svenssonjoel/AnimatronicsController/Hardware/v1/v1.kicad_pcb

## KiCad design Hardware/v1/v1.kicad_pcb (2020-01-16)

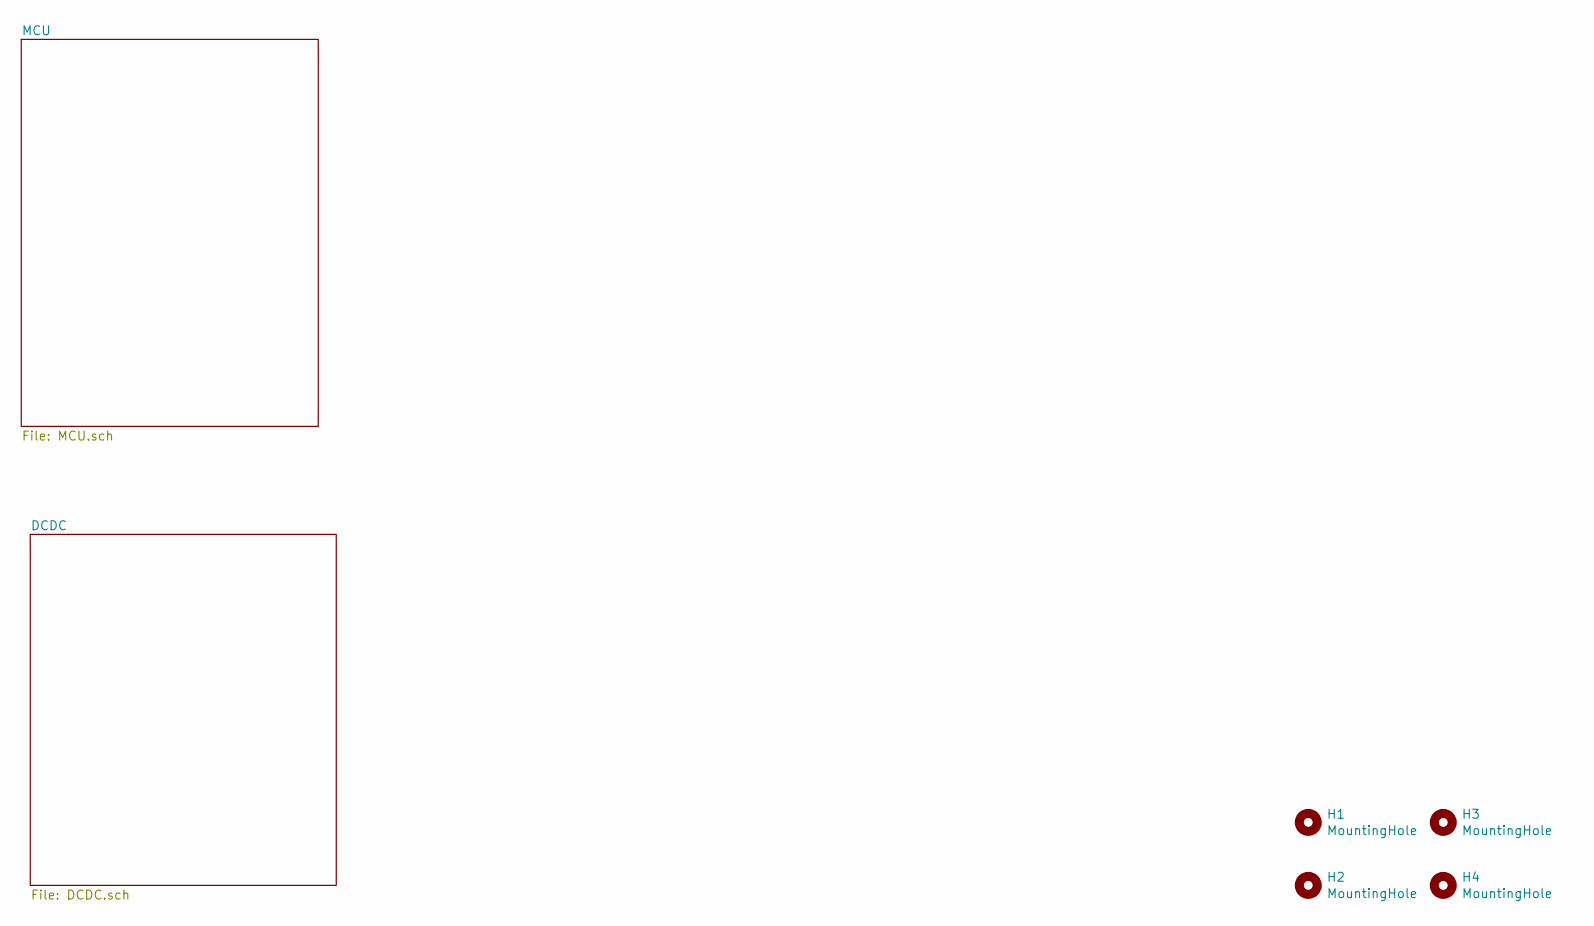
[picture p4: schematic v1.sch]

Parts:
H1, H2, H3, H4: MountingHole; MountingHole_3.2mm_M3

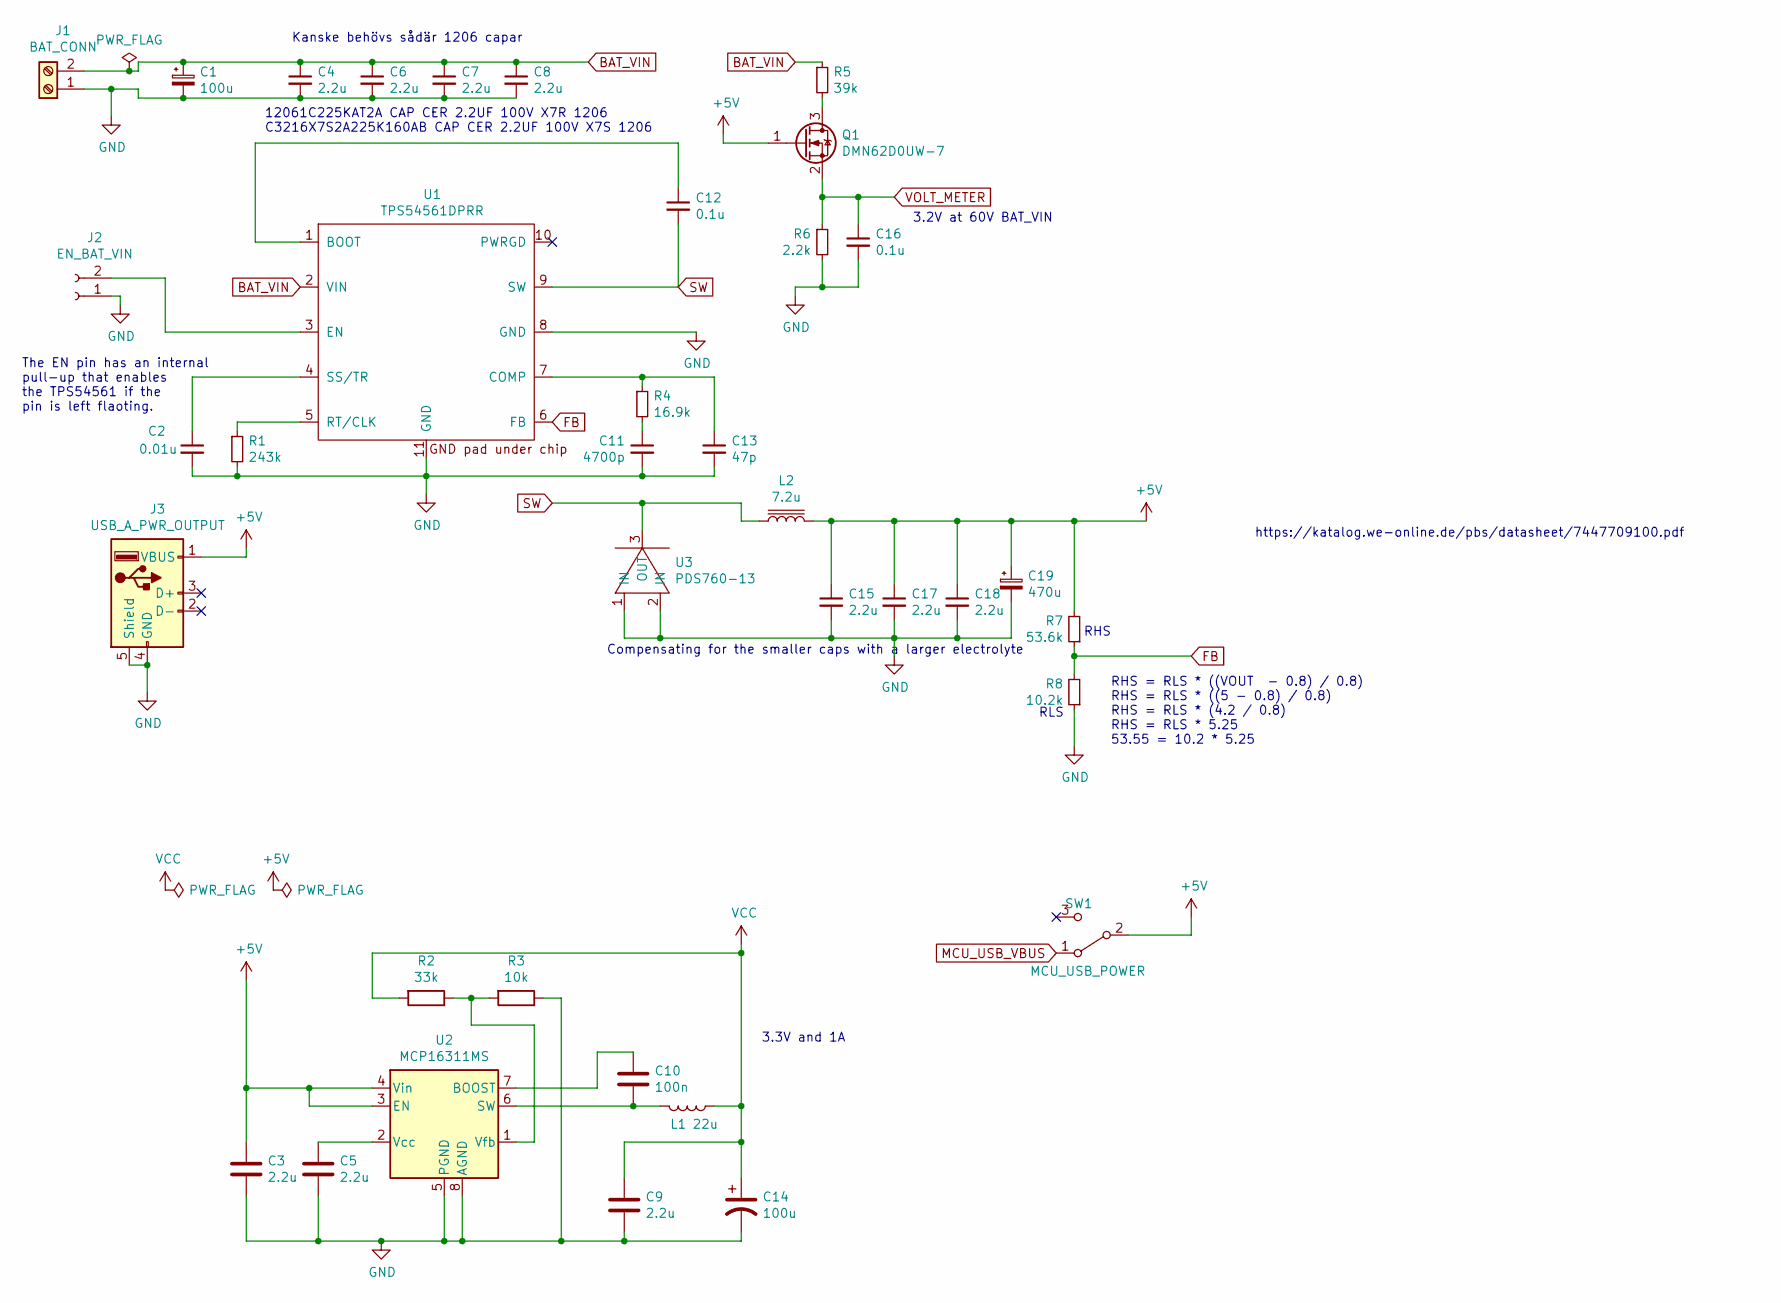
[picture p5: schematic DCDC.sch]

Parts:
C1: 100u; CP_Radial_D10.0mm_P5.00mm
C2: 0.01u; C_0603_1608Metric
C3, C5, C9, C15, C17, C18: 2.2u; C_0603_1608Metric
C4, C6, C7, C8: 2.2u; C_1206_3216Metric
C10: 100n; C_0603_1608Metric
C11: 4700p; C_0603_1608Metric
C12, C16: 0.1u; C_0603_1608Metric
C13: 47p; C_0603_1608Metric
C14: 100u; CP_EIA-3528-12_Kemet-T
C19: 470u; CP_Radial_D10.0mm_P5.00mm
J1: BAT_CONN; TerminalBlock_Phoenix_PT-1,5-2-5.0-H_1x02_P5.00mm_Horizontal
J2: EN_BAT_VIN; JST_PH_B2B-PH-K_1x02_P2.00mm_Vertical
J3: USB_A_PWR_OUTPUT; USB_A_Stewart_SS-52100-001_Horizontal
L1: 22u; L_Taiyo-Yuden_MD-5050
L2: 7.2u; L_12x12mm_H8mm
Q1: DMN62D0UW-7; SOT-323_SC-70
R1: 243k; R_0603_1608Metric
R2: 33k; R_0603_1608Metric
R3: 10k; R_0603_1608Metric
R4: 16.9k; R_0603_1608Metric
R5: 39k; R_0603_1608Metric
R6: 2.2k; R_0603_1608Metric
R7: 53.6k; R_0603_1608Metric
R8: 10.2k; R_0603_1608Metric
SW1: MCU_USB_POWER; SW_SPDT_PCM12
U1: TPS54561DPRR; TI-DPR; digikey 296-40803-1-ND
U2: MCP16311MS; MSOP-8_3x3mm_P0.65mm
U3: PDS760-13; POWERDI5

Connections:
+5V: C3.1, C15.1, C17.1, C18.1, C19.1, J3.1 (VBUS), L2.2, Q1.1 (G), R7.2, SW1.2 (B), U2.3 (EN), U2.4 (Vin); also elsewhere on the board
BAT_VIN: C1.1, C4.1, C6.1, C7.1, C8.1, J1.2, R5.1, U1.2 (VIN)
FB: R7.1, R8.2, U1.6 (FB)
GND: C1.2, C2.2, C3.2, C4.2, C5.2, C6.2, C7.2, C8.2, C9.2, C11.2, C13.2, C14.2, C15.2, C16.2, C17.2, C18.2, C19.2, J1.1, J2.1, J3.4 (GND), J3.5 (Shield), R1.2, R3.1, R6.2, R8.1, U1.8 (GND), U1.11 (GND), U2.5 (PGND), U2.8 (AGND), U3.1 (IN), U3.2 (IN); also elsewhere on the board
MCU_USB_VBUS: SW1.1 (A); also elsewhere on the board
unnamed: C2.1, U1.4 (SS/TR)
unnamed: C5.1, U2.2 (Vcc)
unnamed: C10.1, U2.7 (BOOST)
unnamed: C10.2, L1.2, U2.6 (SW)
unnamed: C11.1, R4.2
unnamed: C12.1, U1.1 (BOOT)
unnamed: C13.1, R4.1, U1.7 (COMP)
unnamed: J2.2, U1.3 (EN)
unnamed: Q1.3 (D), R5.2
unnamed: R1.1, U1.5 (RT/CLK)
unnamed: R2.1, R3.2, U2.1 (Vfb)
SW: C12.2, L2.1, U1.9 (SW), U3.3 (OUT)
VCC: C9.1, C14.1, L1.1, R2.2; also elsewhere on the board
VOLT_METER: C16.1, Q1.2 (S), R6.1; also elsewhere on the board

Notes on the sheet:
3.3V and 1A
The EN pin has an internal pull-up that enables the TPS54561 if the pin is left flaoting.
Kanske behövs sådär 1206 capar
https://katalog.we-online.de/pbs/datasheet/7447709100.pdf
3.2V at 60V BAT_VIN
12061C225KAT2A CAP CER 2.2UF 100V X7R 1206 C3216X7S2A225K160AB CAP CER 2.2UF 100V X7S 1206
RHS = RLS * ((VOUT - 0.8) / 0.8) RHS = RLS * ((5 - 0.8) / 0.8) RHS = RLS * (4.2 / 0.8) RHS = RLS * 5.25 53.55 = 10.2 * 5.25
RHS
RLS
Compensating for the smaller caps with a larger electrolyte

Schematic: MCU.sch

Parts:
C20, C23: 15p; C_0603_1608Metric
C21, C22, C24, C25, C27, C28, C29, C30, C31, C32, C33, C34: 2.2u; C_0603_1608Metric
C26: 100n; C_0603_1608Metric
D1: RED; LED_0603_1608Metric
D2: GREEN; LED_0603_1608Metric
J4: GPIO1; JST_PH_B4B-PH-K_1x04_P2.00mm_Vertical
J5: GPIO2; JST_PH_B4B-PH-K_1x04_P2.00mm_Vertical
J6: GPIO3; JST_PH_B4B-PH-K_1x04_P2.00mm_Vertical
J10: DACS; JST_PH_B2B-PH-K_1x02_P2.00mm_Vertical
J11: SERV_0; PinHeader_1x03_P2.54mm_Vertical
J12: SERV_1; PinHeader_1x03_P2.54mm_Vertical
J13: SERV_2; PinHeader_1x03_P2.54mm_Vertical
J14: SERV_3; PinHeader_1x03_P2.54mm_Vertical
J15: SERV_4; PinHeader_1x03_P2.54mm_Vertical
J16: SERV_5; PinHeader_1x03_P2.54mm_Vertical
J17: SERV_6; PinHeader_1x03_P2.54mm_Vertical
J18: SERV_7; PinHeader_1x03_P2.54mm_Vertical
J19: CAN; JST_PH_B4B-PH-K_1x04_P2.00mm_Vertical
J20: USB_B_Mini; USB_Mini-B_Lumberg_2486_01_Horizontal
P1: SWD; JST_PH_B6B-PH-K_1x06_P2.00mm_Vertical
R9, R10, R22, R27: 1k; R_0603_1608Metric
R11, R14, R15, R16, R17, R18, R19, R20, R21: 220R; R_0603_1608Metric
R12, R13: 22R; R_0603_1608Metric
SW2: BOOT0; SW_SPDT_PCM12
U4: BMI160; Bosch_LGA-14_3x2.5mm_P0.5mm; digikey 828-1057-1-ND
U5: STM32F405RGTx; LQFP-64_10x10mm_P0.5mm
U6: TJA1051TK-3; DFN-8-1EP_3x3mm_P0.65mm_EP1.55x2.4mm
Y1: 8Mhz; Crystal_SMD_5032-4Pin_5.0x3.2mm

Connections:
+5V: C28.2, J11.2, J12.2, J13.2, J14.2, J15.2, J16.2, J17.2, J18.2, J19.4, U6.3 (VCC); also elsewhere on the board
/MCU/GP1: J4.2, U5.9 (PC1)
/MCU/GP2: J4.3, U5.10 (PC2)
/MCU/GP3: J4.4, U5.11 (PC3)
/MCU/GP4: J5.2, U5.53 (PC12)
/MCU/GP5: J5.3, U5.2 (PC13)
/MCU/GP6: J5.4, U5.3 (PC14)
/MCU/GP7: J6.2, U5.22 (PA6)
/MCU/GP8: J6.3, U5.23 (PA7)
/MCU/GP9: J6.4, U5.41 (PA8)
/MCU/SERV1: R14.2, U5.14 (PA0)
/MCU/SERV2: R15.2, U5.15 (PA1)
/MCU/SERV3: R16.2, U5.16 (PA2)
/MCU/SERV4: R17.2, U5.17 (PA3)
/MCU/SERV5: R18.2, U5.26 (PB0)
/MCU/SERV6: R19.2, U5.27 (PB1)
/MCU/SERV7: R20.2, U5.55 (PB3)
/MCU/SERV8: R21.2, U5.56 (PB4)
CANH: J19.3, R11.1, U6.7 (CANH)
CANL: J19.2, R11.2, U6.6 (CANL)
CAN_RX: U5.61 (PB8), U6.4 (RXD)
CAN_TX: U5.62 (PB9), U6.1 (TXD)
GND: C20.1, C21.2, C22.2, C23.1, C24.2, C25.2, C26.1, C27.2, C28.1, C29.2, C30.2, C31.2, C32.2, C33.2, C34.2, D1.1 (K), D2.1 (K), J4.1, J5.1, J6.1, J11.3, J12.3, J13.3, J14.3, J15.3, J16.3, J17.3, J18.3, J19.1, J20.5, J20.6, P1.4, SW2.1 (A), U4.1 (SDO), U4.6 (GNDIO), U4.7 (GND), U5.12 (VSSA), U5.18 (VSS), U5.28 (PB2), U5.63 (VSS), U6.2 (GND), U6.8 (S), U6.9 (GND), Y1.2, Y1.4; also elsewhere on the board
IMU_INT2: U4.9 (INT2), U5.25 (PC5)
LED0: R22.2, U5.51 (PC10)
LED1: R27.2, U5.52 (PC11)
MCU_USB_DM: J20.2, R12.1
MCU_USB_DP: J20.3, R13.1
MCU_USB_VBUS: J20.1, U5.42 (PA9); also elsewhere on the board
NRST: C26.2, P1.2, U5.7 (NRST)
unnamed: C20.2, U5.6 (PH1), Y1.3
unnamed: C23.2, U5.5 (PH0), Y1.1
unnamed: C24.1, U5.31 (VCAP_1)
unnamed: C25.1, U5.47 (VCAP_2)
unnamed: D1.2 (A), R22.1
unnamed: D2.2 (A), R27.1
unnamed: J10.1, U5.20 (PA4)
unnamed: J10.2, U5.21 (PA5)
unnamed: J11.1, R14.1
unnamed: J12.1, R15.1
unnamed: J13.1, R16.1
unnamed: J14.1, R17.1
unnamed: J15.1, R18.1
unnamed: J16.1, R19.1
unnamed: J17.1, R20.1
unnamed: J18.1, R21.1
unnamed: R12.2, U5.44 (PA11)
unnamed: R13.2, U5.45 (PA12)
unnamed: SW2.2 (B), U5.60 (BOOT0)
SCL: R10.2, U4.13 (SCx), U5.29 (PB10)
SDA: R9.2, U4.14 (SDx), U5.30 (PB11)
SWCLK: P1.5, U5.49 (PA14)
SWDIO: P1.3, U5.46 (PA13)
VCC: C21.1, C22.1, C27.1, C29.1, C30.1, C31.1, C32.1, C33.1, C34.1, P1.6, R9.1, R10.1, SW2.3 (C), U4.5 (VDDIO), U4.8 (VDD), U4.12 (CSB), U5.1 (VBAT), U5.13 (VDDA), U5.19 (VDD), U5.32 (VDD), U5.48 (VDD), U5.64 (VDD), U6.5 (VIO); also elsewhere on the board
VOLT_METER: U5.8 (PC0); also elsewhere on the board

Notes on the sheet:
place close to pin 1, 19, 32, 48, 64, 13
PC0 - PC5 has ADC
Servo connectors
LQFP64 TIM 2,3,4,5 PWM (TIM1 is more capable than TIM2 - 5 TIM1 CH1 PIN 23 (N), 27(N), 34(N), 36(N), 41 TIM1 CH2 PIN 42 TIM1 CH3 PIN 43 TIM1 CH4 PIN 44 (Maybe prefer these ?) TIM2 CH1 PIN 14, 21 TIM2 CH2 PIN 15, 55 TIM2 CH3 PIN 16, 29 TIM2 CH4 PIN 17, 30 TIM3 CH1 PIN 37, 56 TIM3 CH2 PIN 38 TIM3 CH3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
Dubbelkoll CSB - VCC. vi ska ha I2c
Place near VDD/GND BMI160

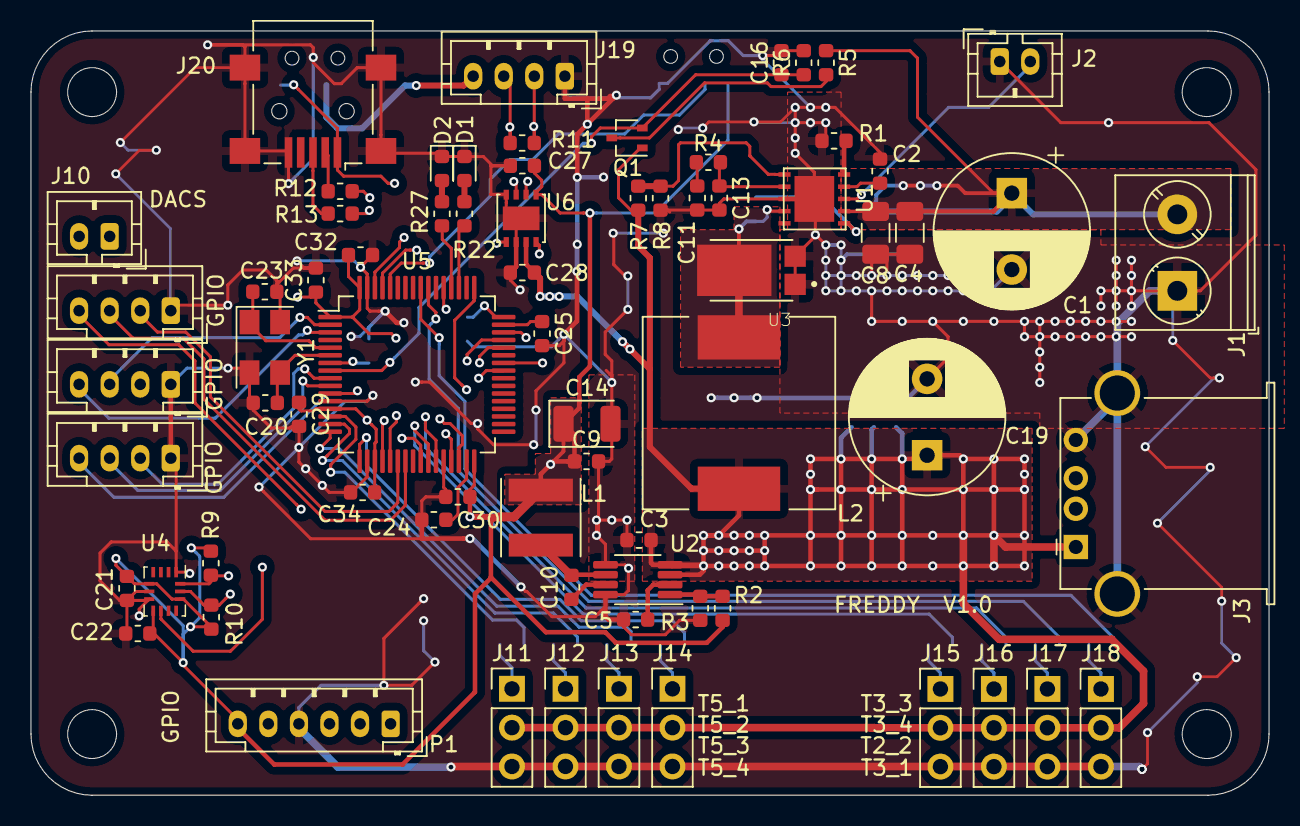
[picture p6: board v1.kicad_pcb from above]

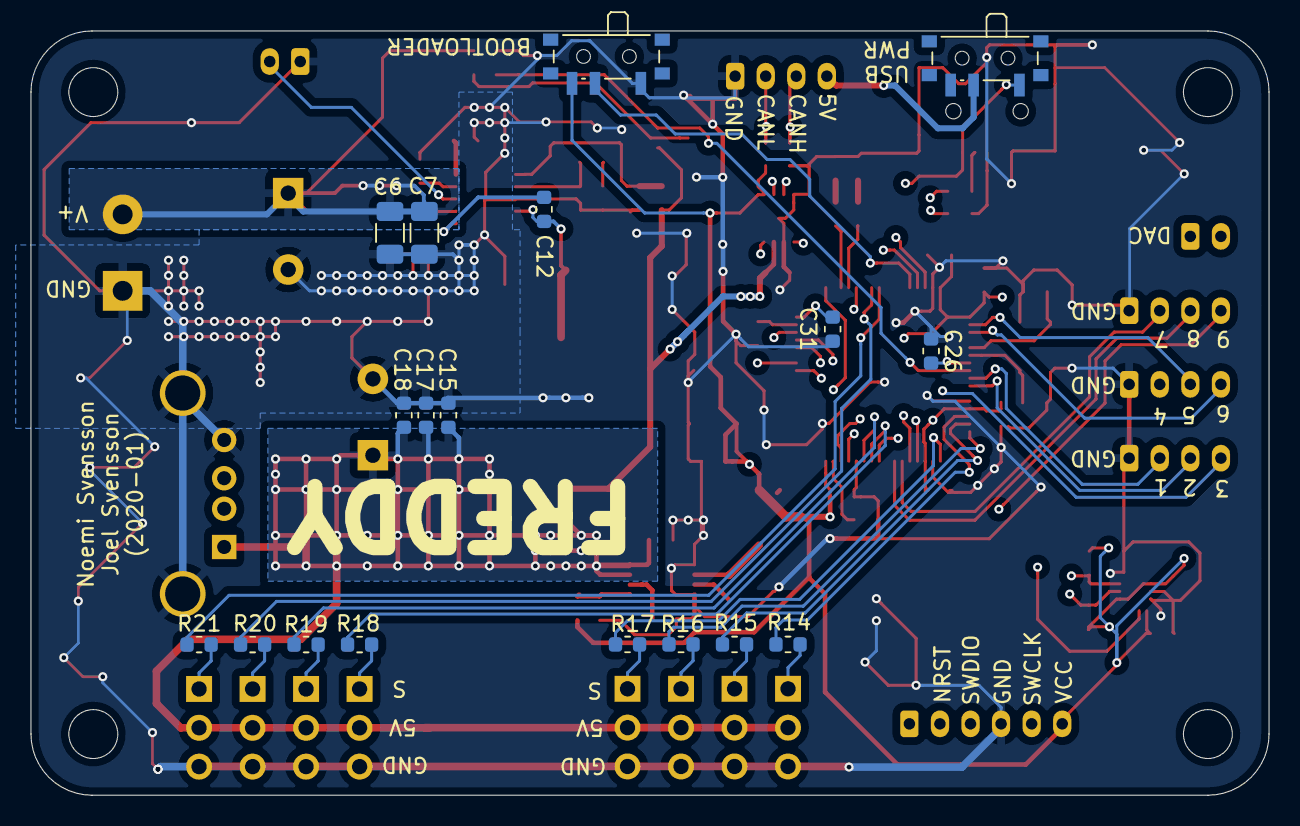
[picture p7: board v1.kicad_pcb from below]

Board: 4 copper layers, 81.0 x 50.0 mm, 93 parts (18 on the bottom side), 69 nets.
