svenssonjoel/AnimatronicsController/firmware/repl.c

/*
    Copyright 2019 Joel Svensson	svenssonjoel@yahoo.se

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
    You should have received a copy of the GNU General Public License
    along with this program.  If not, see <http://www.gnu.org/licenses/>.
*/

#include <ctype.h>

#include "ch.h"
#include "hal.h"

#include "chprintf.h"

#include "led.h"
#include "servos.h"
#include "heap.h"
#include "symrepr.h"
#include "extensions.h"
#include "eval_cps.h"
#include "print.h"
#include "tokpar.h"
#include "prelude.h"

#include "zephyr.h"

#define REPL_WA_SIZE THD_WORKING_AREA_SIZE(10*2048)

VALUE ext_set_led(VALUE *args, int argn) {
  if (argn != 2) {
    return enc_sym(symrepr_nil());
  }

  int led_num = dec_i(args[1]);
  int state   = dec_i(args[0]);

  led_write(led_num, state);

  return enc_sym(symrepr_true());
}

VALUE ext_set_duty(VALUE *args, int argn) {
  if (argn < 2) return enc_sym(symrepr_nil());

  
  int duty = dec_i(args[0]);

  unsigned int servos = 0;
  for (int i = 0; i < argn-1; i ++) {
    int servo  = dec_i(args[i+1]);
    servos |= 1 << servo;
  }

  
  servos_set_duty(servos, duty);
  
  return enc_sym(symrepr_true());
}


unsigned char inbyte(BaseSequentialStream *chp) {
  unsigned char c;
  while (streamRead(chp, &c, 1) == 0);
  return c;
}

void outbyte(BaseSequentialStream *chp, char c) {
  streamPut(chp, c);
}

int inputline(BaseSequentialStream *chp, char *buffer, int size) {
  int n = 0;
  unsigned char c;
  for (n = 0; n < size - 1; n++) {

    c = inbyte(chp);
    switch (c) {
    case 127: /* fall through to below */
    case '\b': /* backspace character received */
      if (n > 0)
        n--;
      buffer[n] = 0;
      outbyte(chp,'\b'); /* output backspace character */
      n--; /* set up next iteration to deal with preceding char location */
      break;
    case '\n': /* fall through to \r */
    case '\r':
      buffer[n] = 0;
      return n;
    default:
      if (isprint(c)) { /* ignore non-printable characters */
        outbyte(chp,c);
        buffer[n] = c;
      } else {
        n -= 1;
      }
      break;
    }
  }
  buffer[size - 1] = 0;
  return 0; // Filled up buffer without reading a linebreak
}


static THD_FUNCTION(repl, arg) {

  BaseSequentialStream *chp = (BaseSequentialStream *)arg;

  size_t len = 1024;
  char *str = malloc(1024);
  char *outbuf = malloc(1024);
  int res = 0;

  heap_state_t heap_state;

  res = symrepr_init();
  if (res)
    chprintf(chp,"Symrepr initialized.\n\r");
  else {
    chprintf(chp,"Error initializing symrepr!\n\r");
    return;
  }
  int heap_size = 2048;
  res = heap_init(heap_size);
  if (res)
    chprintf(chp,"Heap initialized. Free cons cells: %u\n\r", heap_num_free());
  else {
    chprintf(chp,"Error initializing heap!\n\r");
    return;
  }

  res = eval_cps_init(true);
  if (res)
    chprintf(chp,"Evaluator initialized.\n\r");
  else {
    chprintf(chp,"Error initializing evaluator.\n\r");
  }

  if (extensions_add("set-duty", ext_set_duty)) {
    chprintf(chp,"set-duty extension added.\n\r");
  } else {
    chprintf(chp,"set-duty extension failed!\n\r");
  }

  if (extensions_add("set-led",  ext_set_led)) {
    chprintf(chp,"set-led extension added.\n\r");
  } else {
    chprintf(chp,"set-led extension failed!\n\r");
  }


  VALUE prelude = prelude_load();
  eval_cps_program(prelude);

  chprintf(chp,"Lisp REPL started (FMRC)!\n\r");

  while (1) {
    chThdSleepMilliseconds(100);
    chprintf(chp,"# ");
    memset(str,0,len);
    memset(outbuf,0, 1024);
    inputline(chp,str, len);
    chprintf(chp,"\n\r");

    if (strncmp(str, ":info", 5) == 0) {
      chprintf(chp,"##(FMRC)####################################################\n\r");
      chprintf(chp,"Used cons cells: %lu \n\r", heap_size - heap_num_free());
      chprintf(chp,"ENV: "); simple_snprint(outbuf,1023, eval_cps_get_env()); chprintf(chp, "%s \n\r", outbuf);
      heap_get_state(&heap_state);
      chprintf(chp,"GC counter: %lu\n\r", heap_state.gc_num);
      chprintf(chp,"Recovered: %lu\n\r", heap_state.gc_recovered);
      chprintf(chp,"Marked: %lu\n\r", heap_state.gc_marked);
      chprintf(chp,"Free cons cells: %lu\n\r", heap_num_free());
      chprintf(chp,"############################################################\n\r");
      memset(outbuf,0, 1024);
    } else if (strncmp(str, ":quit", 5) == 0) {
      break;
    } else {

      VALUE t;
      t = tokpar_parse(str);

      t = eval_cps_program(t);

      if (dec_sym(t) == symrepr_eerror()) {
	chprintf(chp,"Error\n");
      } else {
	chprintf(chp,"> "); simple_snprint(outbuf, 1023, t); chprintf(chp,"%s \n\r", outbuf);
      }
    }
  }

  symrepr_del();
  heap_del();

}


thread_t *createReplThread(BaseSequentialStream *stream) {

  return chThdCreateFromHeap(NULL,
			     REPL_WA_SIZE,
			     "repl",
			     NORMALPRIO + 1,
			     repl,
			     (void *)stream);
}
