svenssonjoel/AnimatronicsController/(commit log)

2020-01-01 schematics done
    [DCDC.sch, MCU.sch, v1.sch]
2020-01-03 ANITRONBO V1_0
    [v1.kicad_pcb]
2020-01-09 tweaks and simplification
    [MCU.sch, v1.kicad_pcb]
2020-01-09 adding some descriptions on F silks
    [MCU.sch, v1.kicad_pcb]
2020-01-16 added some text to silks
    [v1.kicad_pcb]
2020-02-10 started on firmware
    [STM32L4+.ods, stm_spc56ec74a256s_spc56ec74_minimodule_debug_jtag.cfg, stm_xpc560b64_minimodule_debug_jtag.cfg, stm_xpc560b_spc560d40_minimodule_debug_jtag.cfg, stm_xpc560p_minimodule_40mhz_debug_jtag.cfg, stm_xpc563m64_minimodule_debug_jtag.cfg, stm_xpc564a_spc564a70_minimodule_debug_jtag.cfg, stm_xpc56el_minimodule_lockstep_debug_jtag.cfg]
